skaplich/CMYK_Paint_Mixer_1.0/Photos/Image 10-22-24 at 6.59 PM.JPG

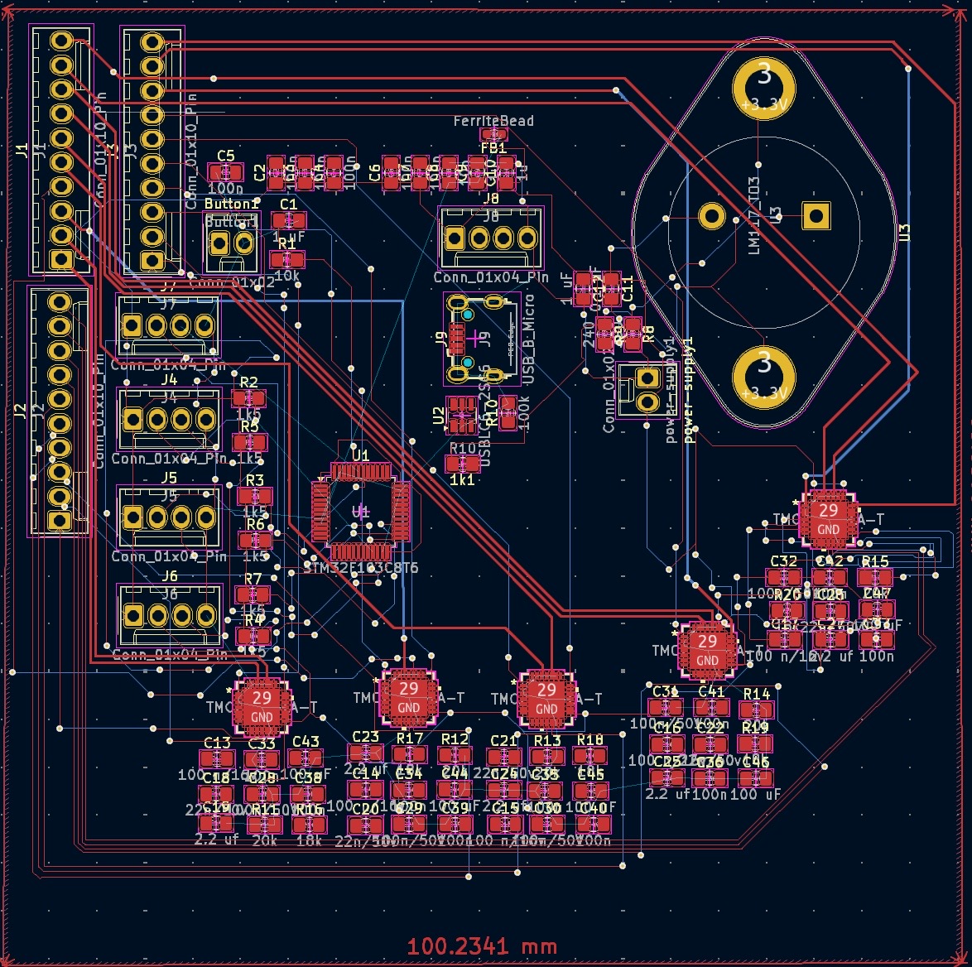
Photos/Image 10-22-24 at 6.59 PM.JPG
