skaplich/CMYK_Paint_Mixer_1.0/notebooks/lucky/kphm100.jpeg

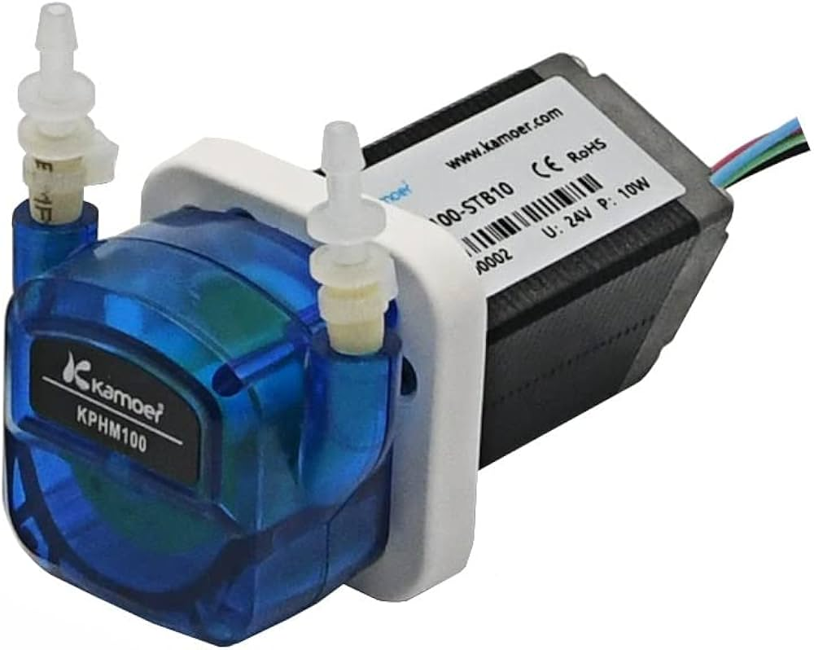
notebooks/lucky/kphm100.jpeg
