skaplich/CMYK_Paint_Mixer_1.0/README.md

LOCKER : 91Y51          03-33-03

# CMYK_Paint_Mixer_1.0
ECE445 Project for FALL 2024

Color Sensor : https://www.adafruit.com/product/3779
