skaplich/CMYK_Paint_Mixer_1.0/notebooks/alexander/README.md

# **ECE 445 Lab Notebook**

## Entry Format:
Date
Brief statement of objectives for that session
Record of what was done

________________________________________________________________________________________________
1. 8/29/24
2. Preliminary Research for the Project + First Web Board Post

Today I'm going to research some ideas for the project and come up with a basic draft for the web board post.
Explaining how to use an RGB sensor : https://www.instructables.com/Color-Detection-Using-RGB-LED/
- Color detection using an rgb sensor
- similarly using an arduino breakout board: https://www.instructables.com/TCS3472-RGB-Light-Color-Sensor-With-Arduino/
RGB (Red, Green, Blue):

Additive Color Model: Combines red, green, and blue light to create colors.
Used for Screens: Displays, monitors, and digital devices.
Color Mixing: Adding colors makes them brighter (e.g., all combined = white).
CMYK (Cyan, Magenta, Yellow, Key/Black):

Subtractive Color Model: Uses ink or pigment to subtract light.
Used for Printing: Paper and physical media.
Color Mixing: Combining colors makes them darker (e.g., all combined = black or muddy brown).

Here is my Web post that I'm going to push today: 

Team :
Lucky Konatham (lrk4)
Alexander Kaplich (kaplich2)
Rajeev Bommana (bommana2)
Problem :
Whenever a painter starts a new project they always begin by mixing their desired colors on their palette using some combination of red, blue yellow and white. However, the painter will inevitably run out of paint, and then will need to mix the exact color that they had before. Speaking from experience this part of the process is very frustrating and time consuming, especially for artists that are bad at mixing colors. Rather than wasting time learning color theory, or buying the color you were using straight from the tube, we will save time and money by designing a machine that can determine the pigments required to mix any color using RGB sensors, and it will also mix it for you using a combination of primary colors so that you don't have to.

Solution :
The idea is pretty simple, the user of the device will "scan" the desired color by using a color sensor that detects the RGB values of a surface using red, green, blue and 'clear' photodiodes. The device will send the RGB values of the color to the onboard mcu which will do some simple calculations to convert the RGB value of the color to CMYK format using conversion formulas. This is the same principle behind color printers which create color images by mixing cyan, magenta, yellow, and black. The mcu will then communicate with 5 stepper drivers which are wired to 5 Stepper motors that will dispense the appropriate amount of white, cyan, magenta, yellow and black paint into a cup. The components will be powered by a non-rechargeable battery bank and the final result should a paint cup with the color that was scanned before. Ideally the person using this tool never needs to actually do any mixing, they can just scan a color and apply it directly on the canvas/work surface.

Materials :
3D Printed device casing

5 Peristaltic Pumps -> 5 Stepper Motors

5 Pump controller -> Stepper Drivers

Status LED's

Small Digital Display

STM32 Series MCU (PCB with similar pins to Dough Monitor)

Battery Bank with some sort of DC jack

Potentially : Buzzer, Bluetooth Control

________________________________________________________________________________________________

9/8/24

Rajeev's post didn't get approved yet Professor wanted some extra information: 

Hello Professor thanks for the feedback, to add on to what Rajeev said, we are planning on using fluid body acyllics,. The key here to to use paints with a low viscosity, that would make pumping a lot easier - as you can imagine a paint similar to oil paint would be really tough to use while something more ink-like and watery like guache/fluid body acryllics would be a lot more feasible.

We would like to have a recharging capability to the project, our initial proposal used a dispensable battery pack just because that seemed at the time much easier to implement and is not really the focus of the project - which you stated is accurately mixing the paint. However we agree that it might be necessary to do this anyway given that we are powering several systems, and being able to recharge our system might be way more convenient in the long run as we test and fix issues.

Also, the calculations required to convert RGB to paint are pretty simply and probably the easiest part of this whole project. There are 6 formulas used to convert RGB to CMYK (the model used in printers. Really these values are just proportions, suppose C is 0.5 and we want 100mL of white paint in the mixture, the amount of Cyan paint needed is 100mL of White * 0.5 = 50mL. Now figuring out how to dispense 50mL of a liquid using a motor is a challenge, but I wouldn't say it's too good to be true. By using Stepper motors which are much more controllable than DC motors and with some motor calibration that Rajeev mentioned before - run the motor for x amount of time at some specific settings and see how much x mL of liquid gets dispensed. If the process ends up being too difficult with our acrylics then we will switch to a paint that is more watery.

R' = R/255
G' = G/255
B' = B/255
K = 1-max(R', G', B')
C = (1-R'-K) / (1-K)
M = (1-G'-K) / (1-K)
Y = (1-B'-K) / (1-K)

![Image]()	
________________________________________________________________________________________________

9/12/24 

PCB Needs to get done in a few weeks let's start looking for parts:
MOTOR https://www.amazon.com/peristaltic-Stepper-KPHM100-Service-high-Precision/dp/B0B99ZH9C1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

MOTOR DRIVER https://www.amazon.com/BIGTREETECH-DIRECT-TMC2209-Stepsticks-Motherboard/dp/B07ZQ3C1XW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
https://www.digikey.com/en/products/detail/analog-devices-inc-maxim-integrated/TMC2209-LA-T/10232491

RGB SENSOR https://www.adafruit.com/product/3779
https://mm.digikey.com/Volume0/opasdata/d220001/medias/docus/758/3779_Web.pdf                
Circuit Protection https://www.digikey.com/en/products/detail/stmicroelectronics/USBLC6-2SC6Y/2819177
24V Power Supply https://www.amazon.com/EMITEVER-Lighting-Transformers-100-240V-UL-Listed/dp/B09S9YF9BX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

Microcontroller https://www.st.com/content/ccc/resource/technical/document/datasheet/group3/98/80/dc/e5/f8/4b/4b/a3/DM00366448/files/DM00366448.pdf/jcr:content/translations/en.DM003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
USB Connection https://www.mouser.com/ProductDetail/Amphenol-Commercial-Products/12401598E42A?qs=367PjNmvCmllVMBVyIyS3w%3D%3D
Display https://www.amazon.com/Enhanced-NX4024K032-Resistive-Function-Dashboard/dp/B0BHN7QKVP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
Voltage Regulator 24V to 3.3V https://www.pololu.com/product/2842 

10.88 for resistors and capacitors

https://jiaolyulu.github.io/kineticSculpture/stepperTMC2209.html

https://learn.watterott.com/silentstepstick/faq/#calculator-tmc21xx-and-tmc2209

https://www.programming-electronics-diy.xyz/2023/12/tmc2209-stepper-driver-module-tutorial.html

 https://forum.arduino.cc/t/tmcstepper-arduino-tmc2209/956036

________________________________________________________________________________________________

9/18/24
TA Weekly Meeting:

** We might need to talk to the machine shop about getting **

Project Kickoff and Initial Brainstorming:

The team introduced the concept of the project: an automated color-detecting paint dispenser designed to streamline color mixing and application processes. This system aims to address challenges faced by artists and industrial users in achieving consistent color reproduction.

Key motivations for the project were outlined, emphasizing efficiency, precision, and user-friendliness. The TA provided feedback on refining these motivations to ensure clear alignment with the course objectives.

Proposal Requirements:

The TA explained the essential components of the project proposal:

Introduction: Establishing the motivation and context of the project.

Problem: Detailed description of the challenges and justification for solving them.

Solution: High-level description of the approach, emphasizing implementation specifics where possible.

Visual Aid: A conceptual diagram illustrating the system's functionality and integration with external systems.

Ethics and Safety: Addressing relevant concerns, including environmental impact and user safety.

Suggestions were made to connect the problem statement with real-world examples, such as automotive paint application and artistic projects.

We really need to research more about possible microncontrollers we should use right now we are learning towards stm32 architecture because they are really beefy and powerful, not sure yet what the scope of the project might be. 

________________________________________________________________________________________________

9/25/25

Project Kickoff and Initial Brainstorming:

For the design doc:  concept of the project: an automated color-detecting paint dispenser designed to streamline color mixing and application processes. This system aims to address challenges faced by artists and industrial users in achieving consistent color reproduction.

Key motivations for the project were outlined, emphasizing efficiency, precision, and user-friendliness. The TA provided feedback on refining these motivations to ensure clear alignment with the course objectives.

Proposal Requirements:

essential components of the project proposal:

Introduction: Establishing the motivation and context of the project.

Problem: Detailed description of the challenges and justification for solving them.

Solution: High-level description of the approach, emphasizing implementation specifics where possible.

Visual Aid: A conceptual diagram illustrating the system's functionality and integration with external systems.

Ethics and Safety: Addressing relevant concerns, including environmental impact and user safety.

Suggestions were made to connect the problem statement with real-world examples, such as automotive paint application and artistic projects.

Action Items:

Me: Begin drafting the problem and solution sections of the proposal.

Rajeev: Research existing automated paint dispensers and their limitations to provide context.

Lucky: Sketch an initial conceptual diagram for the visual aid.

Team: Schedule a follow-up meeting to review individual contributions and consolidate them into a cohesive proposal.

The grades for the proposals and the soldering assignment were released. Chi Zhang advised us to verify our grades for accuracy.
A separate email will be sent detailing where points were deducted from the proposals. Full points can be regained if the proposal is modified and resubmitted before the deadline next week.

Design Document Overview:
The design document is due next week. we need to start reviewing the template and grading rubric on the course website.
Special emphasis was placed on the Requirement and Verification table, which has its own webpage. Formatting must adhere to the standards outlined in the rubric.

Component Orders:
The portal for component orders has not yet opened. In the meantime, the inventory page should be checked for available components.
Components listed in the inventory can be accessed without placing an order.

Project Progress Update Based on our design document draft:

- The RGB sensor and microcontroller interface are outlined, with the sensor converting RGB data to CMYK proportions.

- The motor drivers and peristaltic pumps are described, emphasizing precision in dispensing paint volumes.

- power supply and custom PCB designs have been preliminarily detailed.

- Work on hardware integration and software algorithms for RGB to CMYK conversion is ongoing.

Code for the project

```
/***************************************************************************
  This is a library for the Adafruit AS7262 6-Channel Visible Light Sensor

  This sketch reads the sensor

  Designed specifically to work with the Adafruit AS7262 breakout
  ----> http://www.adafruit.com/products/3779
  
  These sensors use I2C to communicate. The device's I2C address is 0x49
  Adafruit invests time and resources providing this open source code,
  please support Adafruit andopen-source hardware by purchasing products
  from Adafruit!
  
  Written by Dean Miller for Adafruit Industries.
  BSD license, all text above must be included in any redistribution
 ***************************************************************************/

#include <Wire.h>
#include "Adafruit_AS726x.h"

//create the object
Adafruit_AS726x ams;

//buffer to hold raw values
uint16_t sensorValues[AS726x_NUM_CHANNELS];

//buffer to hold calibrated values (not used by default in this example)
//float calibratedValues[AS726x_NUM_CHANNELS];

void setup() {
  Serial.begin(9600);
  while(!Serial);
  
  // initialize digital pin LED_BUILTIN as an output.
  pinMode(LED_BUILTIN, OUTPUT);

  //begin and make sure we can talk to the sensor
  if(!ams.begin()){
    Serial.println("could not connect to sensor! Please check your wiring.");
    while(1);
  }
}

void loop() {

  //read the device temperature
  uint8_t temp = ams.readTemperature();
  
  //ams.drvOn(); //uncomment this if you want to use the driver LED for readings
  ams.startMeasurement(); //begin a measurement
  
  //wait till data is available
  bool rdy = false;
  while(!rdy){
    delay(5);
    rdy = ams.dataReady();
  }
  //ams.drvOff(); //uncomment this if you want to use the driver LED for readings

  //read the values!
  ams.readRawValues(sensorValues);
  //ams.readCalibratedValues(calibratedValues);

  Serial.print("Temp: "); Serial.print(temp);
  Serial.print(" Violet: "); Serial.print(sensorValues[AS726x_VIOLET]);
  Serial.print(" Blue: "); Serial.print(sensorValues[AS726x_BLUE]);
  Serial.print(" Green: "); Serial.print(sensorValues[AS726x_GREEN]);
  Serial.print(" Yellow: "); Serial.print(sensorValues[AS726x_YELLOW]);
  Serial.print(" Orange: "); Serial.print(sensorValues[AS726x_ORANGE]);
  Serial.print(" Red: "); Serial.print(sensorValues[AS726x_RED]);
  Serial.println();
  Serial.println();
}

```

________________________________________________________________________________________________

9/28/24

Grades Released:

The grades for the proposals were released. The TA advised us to verify our grades for accuracy.

Give quantitative high level requirements when possible                                                   -1
Visual aid: only has 4 motors but the solution says there are 5.                                         -1
Block diagram: make professional block diagram see template Fall 2022 group 1            -1
Label the component (chip number) and subsystems on the block diagram.                     -1
Need quantitative requirement for your color detection                                                       -0
Give formula/calculation process for how much paint the dispenser should output            -1
Describe the process of controlling the motor (how to determine the PWM, and the duration of operation) and how Low flow peristaltic pumps work even if you are buying them off the shelf.                                                                                                                                                        -1

Started Board layout: 
	

________________________________________________________________________________________________

10/16/24

final PCB is complete, we need to solder it and test it. 

Right now Lucky is responsible for ordering all the parts so I need to talk to him about making orders.

________________________________________________________________________________________________

12/2/24

Final Code for the Demo

```
void loop() {
 
  offButtonState = digitalRead(PD2);

  if (offButtonState) {

    digitalWrite(PD7, LOW);

    ams.drvOn(); //uncomment this if you want to use the driver LED for readings

    ams.startMeasurement();  //begin a measurement

    //wait till data is available
    bool rdy = false;
    while (!rdy) {
      delay(5);
      rdy = ams.dataReady();
    }
    ams.drvOff();  //uncomment this if you want to use the driver LED for readings

    //read the values!
    ams.readRawValues(sensorValues);

    int rval = ((sensorValues[AS726x_RED] / 5500.00) * 255.00);
    int gval = ((sensorValues[AS726x_GREEN] / 10500.00) * 255.00);
    int bval = ((sensorValues[AS726x_BLUE] / 12000.00) * 255.00);

    if (rval > 255) {
      rval = 255;
    }
    if (bval > 255) {
      bval = 255;
    }
    if (gval > 255) {
      gval = 255;
    }

    Serial.print("red :");
    Serial.println(rval);
    Serial.println(sensorValues[AS726x_RED]);
    Serial.print("green : ");
    Serial.println(gval);
    Serial.println(sensorValues[AS726x_GREEN]);
    Serial.print("blue : ");
    Serial.println(bval);
    Serial.println(sensorValues[AS726x_BLUE]);

    float R_prime = rval / 255.0;
    float G_prime = gval / 255.0;
    float B_prime = bval / 255.0;

    // Calculate K (Key)
    float K = 1 - max(max(R_prime, G_prime), B_prime);

    // Avoid division by zero when K == 1
    float C = (K < 1) ? (1 - R_prime - K) / (1 - K) : 0;
    float M = (K < 1) ? (1 - G_prime - K) / (1 - K) : 0;
    float Y = (K < 1) ? (1 - B_prime - K) / (1 - K) : 0;

    float white = 100;

    float cyan = C * white;
    float magenta = M * white;
    float yellow = Y * white;
    float black = K * white;

    float mlstep = (226935-25500)/40;
    float tube = 25500;

    float cyan_motorstep = (cyan / 25) * mlstep;
    float magenta_motorstep = (magenta / 25) * mlstep;
    float yellow_motorstep = (yellow / 25) * mlstep;
    float black_motorstep = (black / 25) * mlstep;

    Serial.println(cyan_motorstep);
    Serial.println(magenta_motorstep);
    Serial.println(yellow_motorstep);
    Serial.println(black_motorstep);

  if(cyan_motorstep > 0.00){

    for (long i = 0; i < (long)((tube * 1.25)+cyan_motorstep); i++) {
      digitalWrite(PD6, HIGH);
      //digitalWrite(PD4, HIGH);
      delayMicroseconds(100);
      digitalWrite(PD6, LOW);
      //digitalWrite(PD4, LOW);
      delayMicroseconds(100);
    }
  }
    
    Serial.println("cyan complete");

    if(magenta_motorstep > 0.00){

      for (long i = 0; i < (long)((tube * 1.25)+magenta_motorstep); i++) {
        digitalWrite(PD4, HIGH);
        //digitalWrite(PD4, HIGH);
        delayMicroseconds(100);
        digitalWrite(PD4, LOW);
        //digitalWrite(PD4, LOW);
        delayMicroseconds(100);
      }
    }
    Serial.println("magenta complete");

    if(yellow_motorstep > 0.00){

      for (long i = 0; i < (long)((tube * 1.25)+yellow_motorstep); i++) {
        digitalWrite(A3, HIGH);
        //digitalWrite(PD4, HIGH);
        delayMicroseconds(100);
        digitalWrite(A3, LOW);
        //digitalWrite(PD4, LOW);
        delayMicroseconds(100);
      }
    }

    Serial.println("yellow complete");

    if(black_motorstep > 0.00){

      for (long i = 0; i < (long)((tube * 1.25)+black_motorstep); i++) {
        digitalWrite(A1, HIGH);
        //digitalWrite(PD4, HIGH);
        delayMicroseconds(100);
        digitalWrite(A1, LOW);
        //digitalWrite(PD4, LOW);
        delayMicroseconds(100);
      }

    }
    Serial.println("black complete");

    delay(1000);

    digitalWrite(A0, LOW);

    digitalWrite(PD5, LOW);  //dir motor 1

    digitalWrite(PD3, LOW);  //dir motor 2

    digitalWrite(A2, LOW);

    delay(1000);

    for(long i = 0; i<long((tube*1.25)+1000); i++)
    {

          digitalWrite(PD6, HIGH);

          digitalWrite(PD4, HIGH);

          digitalWrite(A3, HIGH);
          
          digitalWrite(A1, HIGH);

          delayMicroseconds(100);

          digitalWrite(PD6, LOW);

          digitalWrite(PD4, LOW);

          digitalWrite(A3, LOW);

          digitalWrite(A1, LOW);

          delayMicroseconds(100);

          counter++;
          flag = 1;
    }

  digitalWrite(PD5, HIGH);  // dir

  digitalWrite(PD3, HIGH);  // dir

  digitalWrite(A0, HIGH);

  digitalWrite(A2, HIGH);

  digitalWrite(PD7, HIGH);
  
  }
```
