skaplich/CMYK_Paint_Mixer_1.0/notebooks/lucky/arduinouno.png

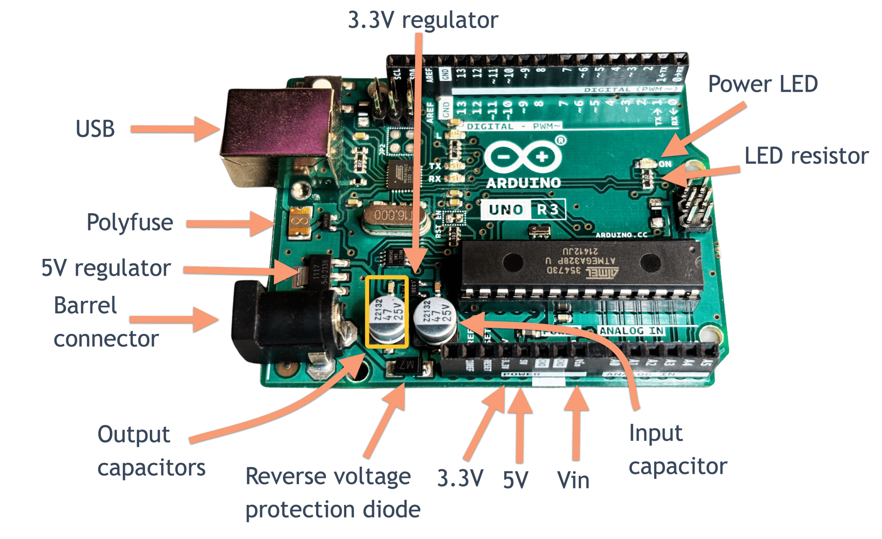
notebooks/lucky/arduinouno.png
