skaplich/CMYK_Paint_Mixer_1.0/notebooks/lucky/cmyk.jpeg

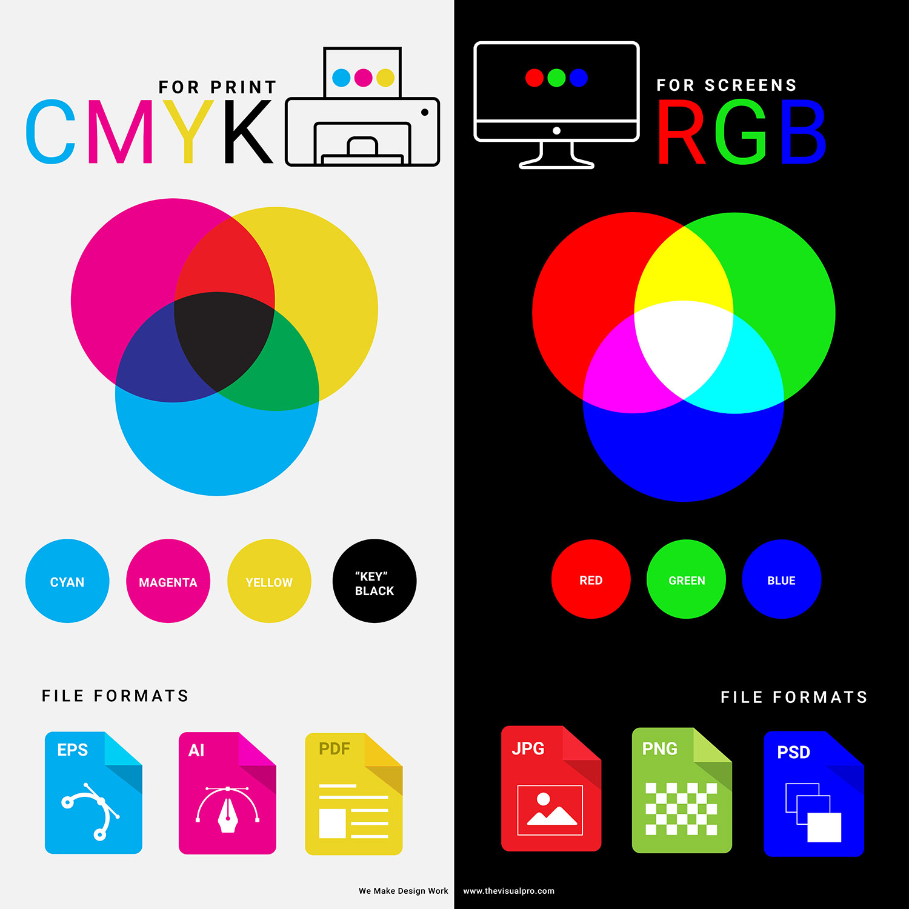
notebooks/lucky/cmyk.jpeg
