skaplich/CMYK_Paint_Mixer_1.0/notebooks/lucky/code.png

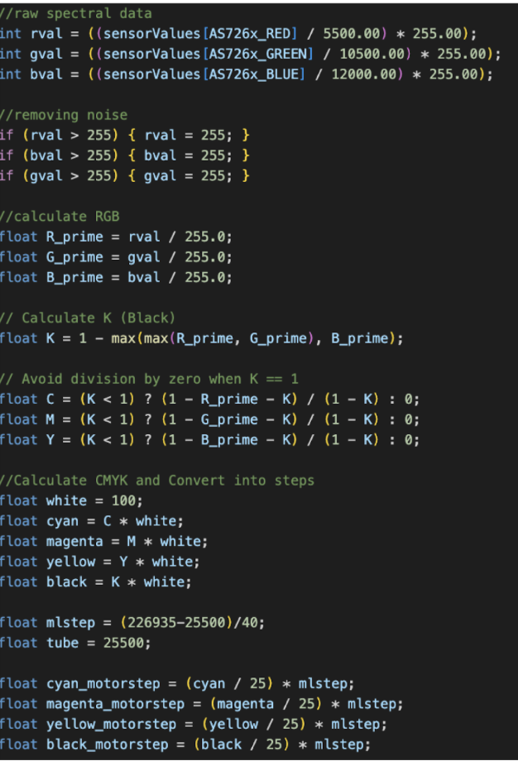
notebooks/lucky/code.png
