skaplich/CMYK_Paint_Mixer_1.0/notebooks/lucky/colorsensor.jpeg

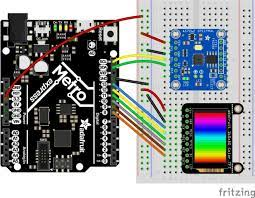
notebooks/lucky/colorsensor.jpeg
