skaplich/CMYK_Paint_Mixer_1.0/notebooks/lucky/tmc2209.jpeg

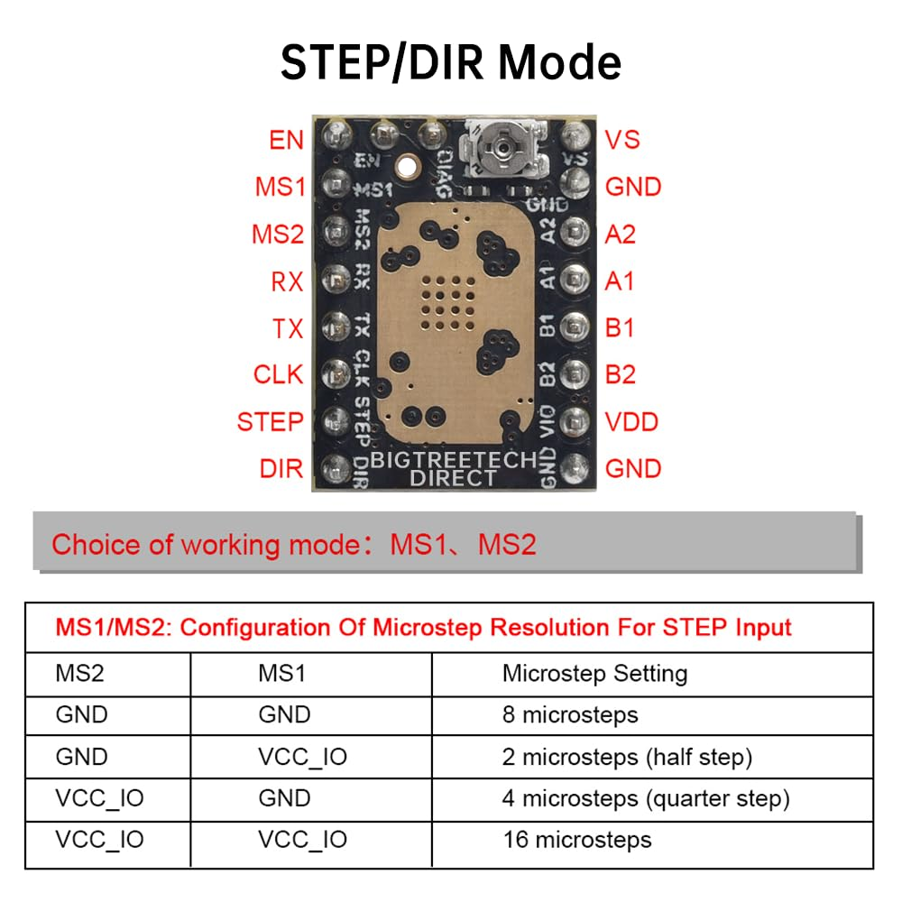
notebooks/lucky/tmc2209.jpeg
