skaplich/CMYK_Paint_Mixer_1.0/Photos/pcbv2.png

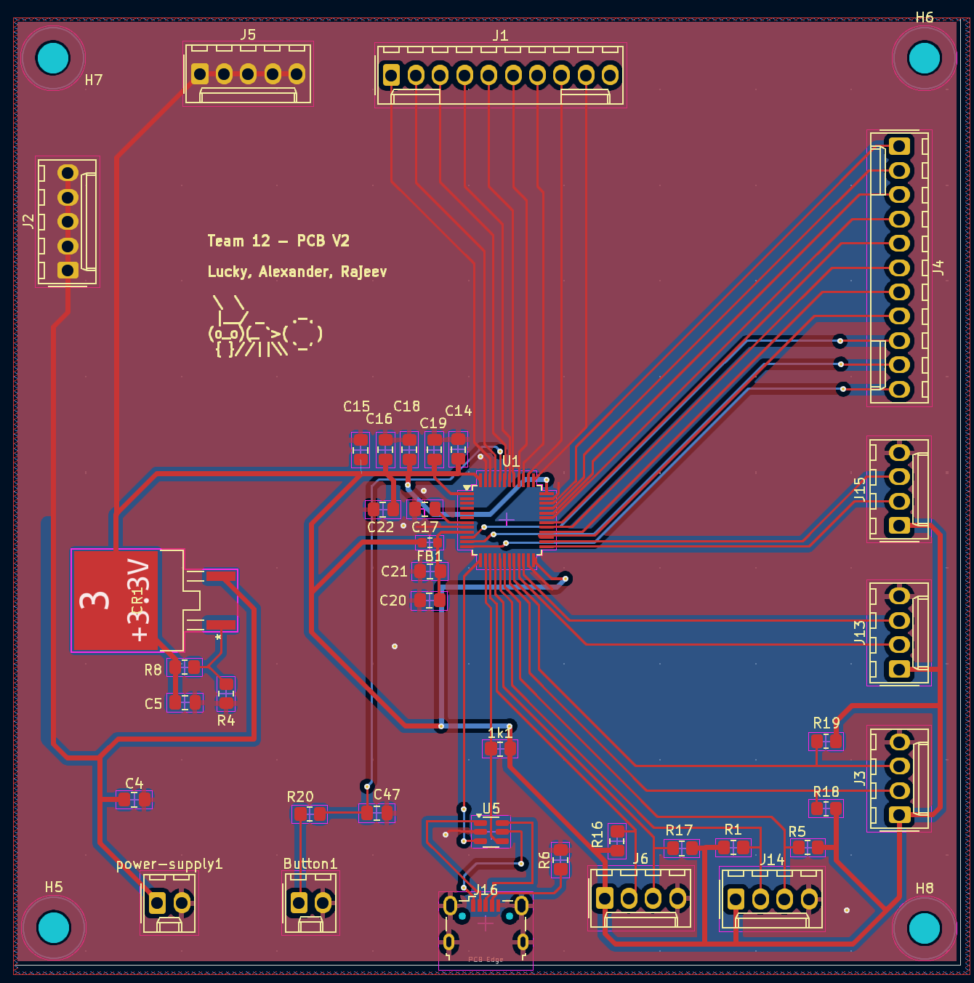
Photos/pcbv2.png
