skaplich/CMYK_Paint_Mixer_1.0/Photos/sc.png

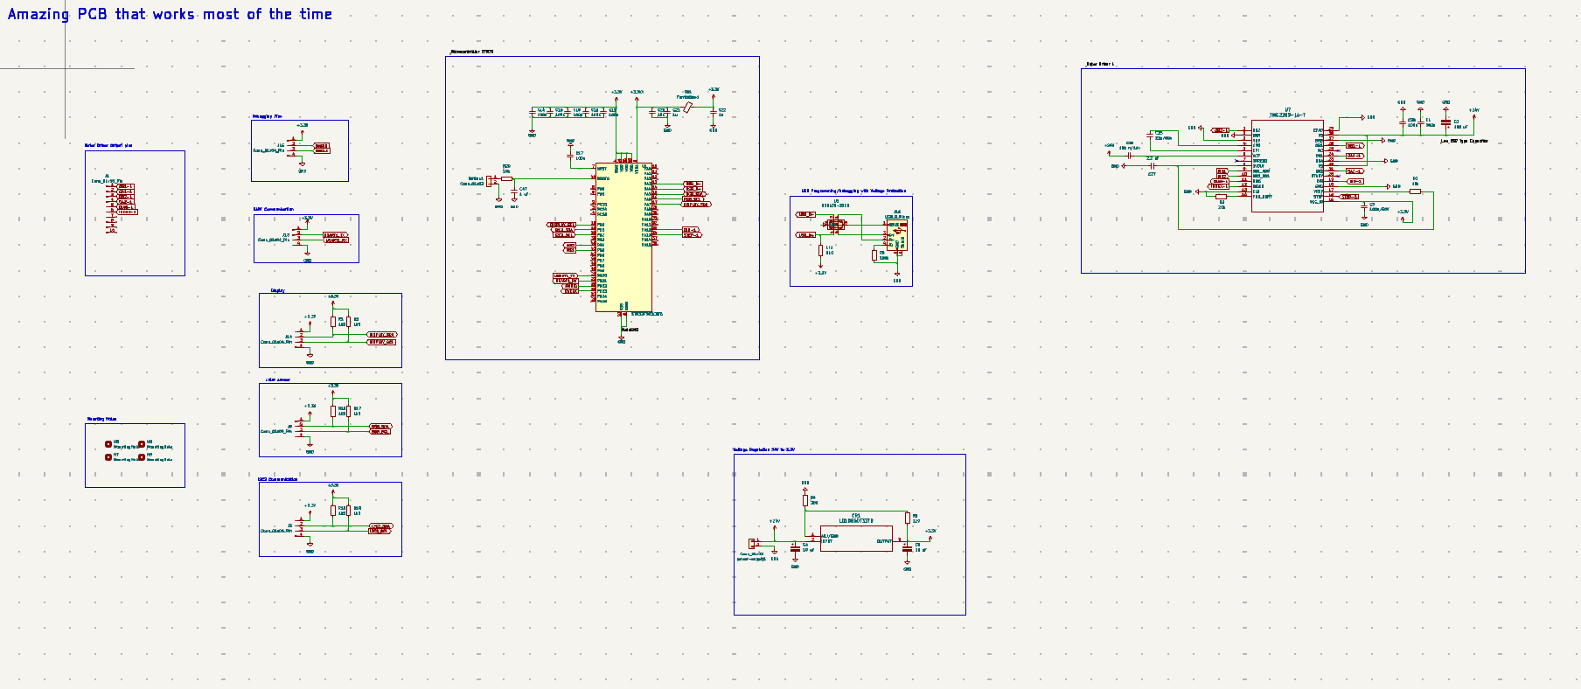
Photos/sc.png
