skaplich/CMYK_Paint_Mixer_1.0/Presentation Material/Copy of 445 printout.pdf

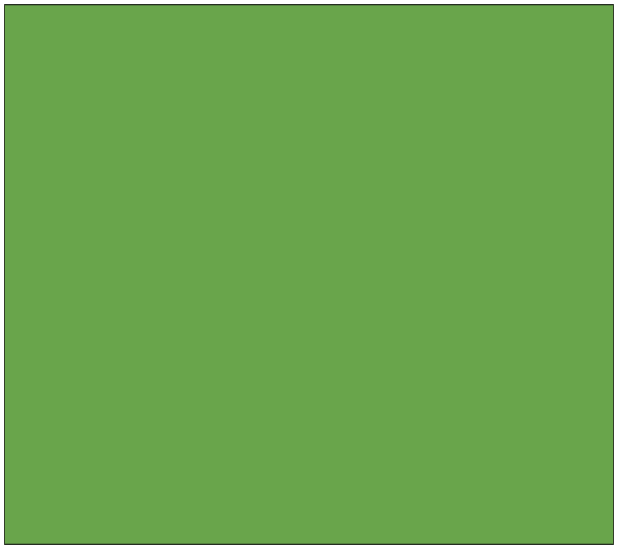
[picture p15: figure]

105, 169, 79

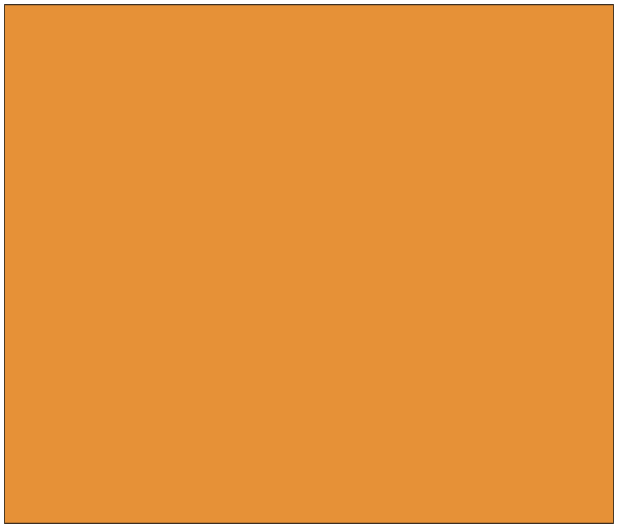
[picture p16: figure]

230, 145, 56

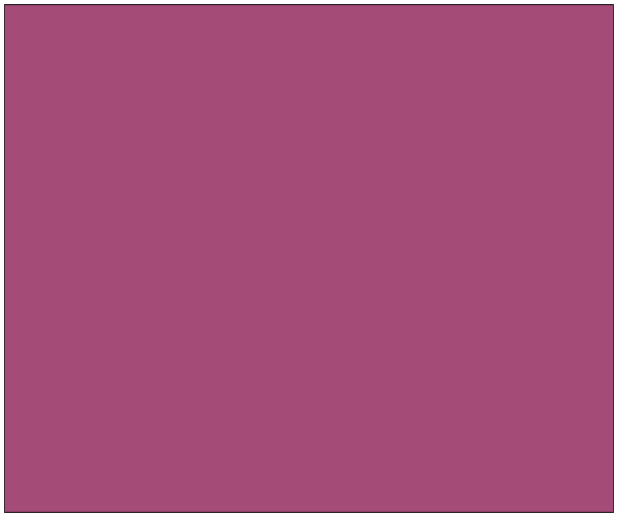
[picture p17: figure]

166, 77, 122
