skaplich/CMYK_Paint_Mixer_1.0/Code/ColortoRGBLED/LuckyPCB 2/LuckyPCB.kicad_pcb

## KiCad design Code/ColortoRGBLED/LuckyPCB 2/LuckyPCB.kicad_pcb (2024-12-12)

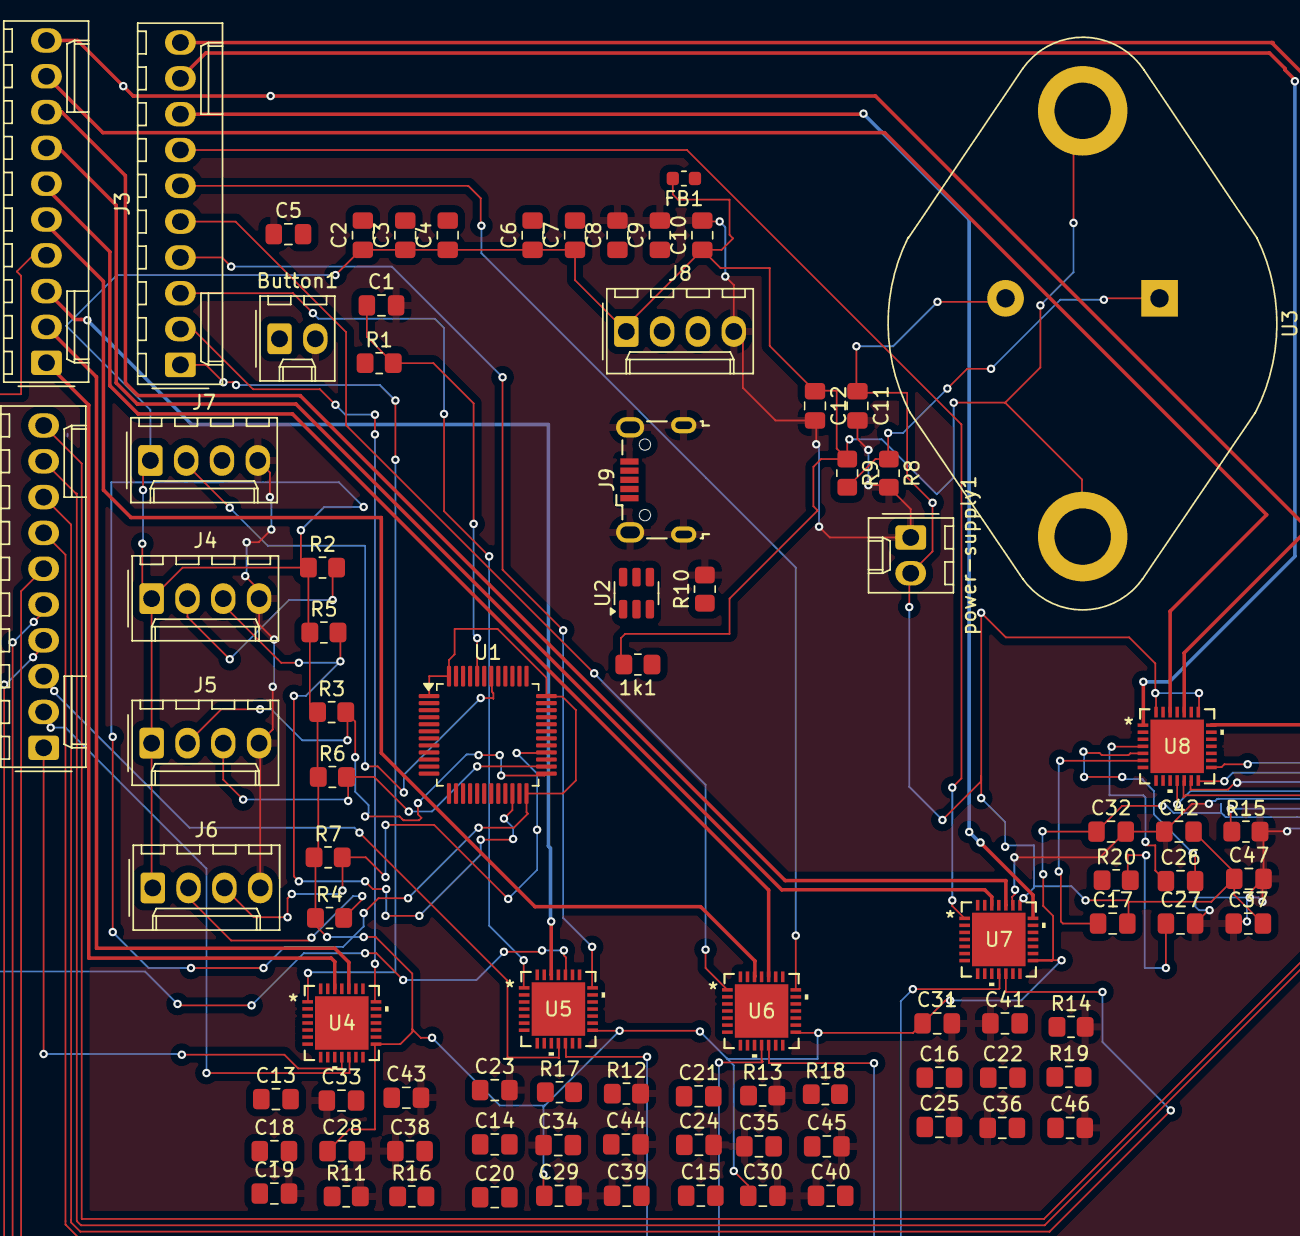
[picture p18: board LuckyPCB.kicad_pcb from above]

Board: 2 copper layers, 88 parts (0 on the bottom side), 97 nets.

Parts:
1k1: R10; R_0805_2012Metric_Pad1.20x1.40mm_HandSolder
Button1: Conn_01x02; Molex_KK-254_AE-6410-02A_1x02_P2.54mm_Vertical
C1, C12: 1 uF; C_0805_2012Metric_Pad1.18x1.45mm_HandSolder
C2, C3, C4, C5, C6, C7, C33, C34, C35, C36, C37, C38, C39, C40, C41, C42: 100n; C_0805_2012Metric_Pad1.18x1.45mm_HandSolder
C8: 10n; C_0805_2012Metric_Pad1.18x1.45mm_HandSolder
C9, C10: 1u; C_0805_2012Metric_Pad1.18x1.45mm_HandSolder
C11: 0.1 uF; C_0805_2012Metric_Pad1.18x1.45mm_HandSolder
C13, C14, C15, C16, C17: 100 n/16v; C_0805_2012Metric_Pad1.18x1.45mm_HandSolder
C18, C20, C21, C22, C26: 22n/50v; C_0805_2012Metric_Pad1.18x1.45mm_HandSolder
C19, C23, C24, C25, C27: 2.2 uf; C_0805_2012Metric_Pad1.18x1.45mm_HandSolder
C28, C29, C30, C31, C32: 100n/50V; C_0805_2012Metric_Pad1.18x1.45mm_HandSolder
C43, C44, C45, C46, C47: 100 uF; C_0805_2012Metric_Pad1.18x1.45mm_HandSolder
FB1: FerriteBead; L_0603_1608Metric
J1, J2, J3: Conn_01x10_Pin; Molex_KK-254_AE-6410-10A_1x10_P2.54mm_Vertical
J4, J5, J6, J7, J8: Conn_01x04_Pin; Molex_KK-254_AE-6410-04A_1x04_P2.54mm_Vertical
J9: USB_B_Micro; USB_Micro-B_Wuerth_629105150521
R1: 10k; R_0805_2012Metric_Pad1.20x1.40mm_HandSolder
R2, R3, R4, R5, R6, R7: 1k5; R_0805_2012Metric_Pad1.20x1.40mm_HandSolder
R8: 390; R_0805_2012Metric_Pad1.20x1.40mm_HandSolder
R9: 240; R_0805_2012Metric_Pad1.20x1.40mm_HandSolder
R10: 100k; R_0805_2012Metric_Pad1.20x1.40mm_HandSolder
R11, R12, R13, R14, R15: 20k; R_0805_2012Metric_Pad1.20x1.40mm_HandSolder
R16, R17, R18, R19, R20: 18k; R_0805_2012Metric_Pad1.20x1.40mm_HandSolder
U1: STM32F103C8T6; LQFP-48_7x7mm_P0.5mm
U2: USBLC6-2SC6; SOT-23-6
U3: LM117_TO3; TO-3
U4, U5, U6, U7, U8: TMC2209-LA-T; QFN28_5X5_3X8_EPAD_TRI
power-supply1: Conn_01x02; Molex_KK-254_AE-6410-02A_1x02_P2.54mm_Vertical

Connections:
+3.3V: 1k1.2, C2.1, C3.1, C4.1, C6.1, C7.1, C10.1, C12.1, C28.1, C29.1, C30.1, C31.1, C32.1, FB1.2, J4.1, J5.1, J6.1, J7.1, J8.1, R2.1, R3.1, R4.1, R5.1, R6.1, R7.1, R9.1, U1.1 (VBAT), U1.24 (VDD), U1.36 (VDD), U1.48 (VDD), U3.3 (VO), U4.15 (VCC_IO), U5.15 (VCC_IO), U6.15 (VCC_IO), U7.15 (VCC_IO), U8.15 (VCC_IO)
+3.3VA: C8.1, C9.1, FB1.1, U1.9 (VDDA)
+24V: C11.1, C13.2, C14.2, C15.2, C16.2, C17.2, C33.2, C34.2, C35.2, C36.2, C37.2, C38.2, C39.2, C40.2, C41.2, C42.2, C43.1, C44.1, C45.1, C46.1, C47.1, U3.2 (VI), U4.22 (VS), U4.28 (VS), U5.22 (VS), U5.28 (VS), U6.22 (VS), U6.28 (VS), U7.22 (VS), U7.28 (VS), U8.22 (VS), U8.28 (VS), power-supply1.2
/I2C2_SCL: J4.2, R2.2, U1.21 (PB10)
/USART1_RX: J7.3, U1.43 (PB7)
DIAG-1: J2.1, U4.11 (DIAG)
DIAG-2: J2.3, U5.11 (DIAG)
DIAG-3: J2.5, U6.11 (DIAG)
DIAG-4: J2.7, U7.11 (DIAG)
DIAG-5: J2.9, U8.11 (DIAG)
DIR-1: U1.10 (PA0), U4.19 (DIR)
DIR-2: U1.12 (PA2), U5.19 (DIR)
DIR-3: U1.14 (PA4), U6.19 (DIR)
DIR-4: U1.16 (PA6), U7.19 (DIR)
DIR-5: U1.29 (PA8), U8.19 (DIR)
GND: Button1.2, C1.2, C5.1, C8.2, C9.2, C10.2, C11.2, C12.2, C19.2, C23.2, C24.2, C25.2, C27.2, C28.2, C29.2, C30.2, C31.2, C32.2, C33.1, C34.1, C35.1, C36.1, C37.1, C38.1, C39.1, C40.1, C41.1, C42.1, C43.2, C44.2, C45.2, C46.2, C47.2, J4.4, J5.4, J6.4, J7.4, J8.4, J9.5 (GND), J9.6 (Shield), R8.2, R10.2, R11.2, R12.2, R13.2, R14.2, R15.2, U1.8 (VSSA), U1.23 (VSS), U1.35 (VSS), U1.47 (VSS), U2.2 (GND), U4.2 (ENN), U4.3 (GND), U4.13 (CLK), U4.18 (GND), U4.23 (BRA), U4.27 (BRB), U4.29 (EPAD), U5.2 (ENN), U5.3 (GND), U5.13 (CLK), U5.18 (GND), U5.23 (BRA), U5.27 (BRB), U5.29 (EPAD), U6.2 (ENN), U6.3 (GND), U6.13 (CLK), U6.18 (GND), U6.23 (BRA), U6.27 (BRB), U6.29 (EPAD), U7.2 (ENN), U7.3 (GND), U7.13 (CLK), U7.18 (GND), U7.23 (BRA), U7.27 (BRB), U7.29 (EPAD), U8.2 (ENN), U8.3 (GND), U8.13 (CLK), U8.18 (GND), U8.23 (BRA), U8.27 (BRB), U8.29 (EPAD), power-supply1.1
INDEX-1: J2.2, U4.12 (INDEX)
INDEX-2: J2.4, U5.12 (INDEX)
INDEX-3: J2.6, U6.12 (INDEX)
INDEX-4: J2.8, U7.12 (INDEX)
INDEX-5: J2.10, U8.12 (INDEX)
MS1: U1.18 (PB0), U4.9 (MS1_AD0), U5.9 (MS1_AD0), U6.9 (MS1_AD0), U7.9 (MS1_AD0), U8.9 (MS1_AD0)
MS2: U1.19 (PB1), U4.10 (MS2_AD1), U5.10 (MS2_AD1), U6.10 (MS2_AD1), U7.10 (MS2_AD1), U8.10 (MS2_AD1)
unnamed: Button1.1, R1.1
unnamed: C2.2, C3.2, C4.2, C6.2, C7.2
unnamed: J4.3, R5.2, U1.22 (PB11)
unnamed: J5.2, R3.2, U1.25 (PB12)
unnamed: J5.3, R6.2, U1.26 (PB13)
unnamed: J6.2, R4.2, U1.27 (PB14)
unnamed: J6.3, R7.2, U1.28 (PB15)
unnamed: J7.2, U1.42 (PB6)
unnamed: J8.2, U1.34 (PA13)
unnamed: J8.3, U1.37 (PA14)
unnamed: J9.3 (D+), U2.6 (I/O1)
unnamed: J9.2 (D-), U2.1 (I/O1)
unnamed: J9.4 (ID), R10.1
unnamed: J9.1 (VBUS), U2.5 (VBUS)
unnamed: C1.1, R1.2, U1.44 (BOOT0)
unnamed: C5.2, U1.7 (NRST)
unnamed: U1.32 (PA11), U2.3 (I/O2)
unnamed: 1k1.1, U1.33 (PA12), U2.4 (I/O2)
unnamed: R8.1, R9.2, U3.1 (ADJ)
unnamed: C19.1, R16.2, U4.8 (5VOUT)
unnamed: C18.2, U4.5 (CPI)
unnamed: C18.1, U4.4 (CPO)
unnamed: R11.1, U4.14 (PDN_UART)
unnamed: C13.1, U4.6 (VCP)
unnamed: R16.1, U4.17 (VREF)
unnamed: C23.1, R17.2, U5.8 (5VOUT)
unnamed: C20.2, U5.5 (CPI)
unnamed: C20.1, U5.4 (CPO)
unnamed: R12.1, U5.14 (PDN_UART)
unnamed: C14.1, U5.6 (VCP)
unnamed: R17.1, U5.17 (VREF)
unnamed: C24.1, R18.2, U6.8 (5VOUT)
unnamed: C21.2, U6.5 (CPI)
unnamed: C21.1, U6.4 (CPO)
unnamed: R13.1, U6.14 (PDN_UART)
unnamed: C15.1, U6.6 (VCP)
unnamed: R18.1, U6.17 (VREF)
unnamed: C25.1, R19.2, U7.8 (5VOUT)
unnamed: C22.2, U7.5 (CPI)
unnamed: C22.1, U7.4 (CPO)
unnamed: R14.1, U7.14 (PDN_UART)
unnamed: C16.1, U7.6 (VCP)
unnamed: R19.1, U7.17 (VREF)
unnamed: C27.1, R20.2, U8.8 (5VOUT)
unnamed: C26.2, U8.5 (CPI)
unnamed: C26.1, U8.4 (CPO)
unnamed: R15.1, U8.14 (PDN_UART)
unnamed: C17.1, U8.6 (VCP)
unnamed: R20.1, U8.17 (VREF)
OA1-1: J1.2, U4.24 (OA1)
OA1-2: J1.4, U5.24 (OA1)
OA1-3: J1.6, U6.24 (OA1)
OA1-4: J1.8, U7.24 (OA1)
OA1-5: J1.10, U8.24 (OA1)
OA2-1: J3.2, U4.21 (OA2)
OA2-2: J3.4, U5.21 (OA2)
OA2-3: J3.6, U6.21 (OA2)
OA2-4: J3.8, U7.21 (OA2)
OA2-5: J3.10, U8.21 (OA2)
OB1-1: J1.1, U4.26 (OB1)
OB1-2: J1.3, U5.26 (OB1)
OB1-3: J1.5, U6.26 (OB1)
OB1-4: J1.7, U7.26 (OB1)
OB1-5: J1.9, U8.26 (OB1)
OB2-1: J3.1, U4.1 (OB2)
OB2-2: J3.3, U5.1 (OB2)
OB2-3: J3.5, U6.1 (OB2)
OB2-4: J3.7, U7.1 (OB2)
OB2-5: J3.9, U8.1 (OB2)
STEP-1: U1.11 (PA1), U4.16 (STEP)
STEP-2: U1.13 (PA3), U5.16 (STEP)
STEP-3: U1.15 (PA5), U6.16 (STEP)
STEP-4: U1.17 (PA7), U7.16 (STEP)
STEP-5: U1.30 (PA9), U8.16 (STEP)
