skaplich/CMYK_Paint_Mixer_1.0/(commit log)

2024-10-20 Add files via upload
    Adding pcb project files
2024-11-12 Add files via upload
    These are the files I submitted for the second order of pcbway
    The gerber 2 folder has the gerber files I sent
2024-12-12 Adding Documentation
    documents and files saved over the course of the project
    [LuckyPCB.kicad_pcb, LuckyPCB.kicad_sch]
2024-12-12 pcbpic2
    pcbpic2
